LucasCorrea02/-Projeto---Acionamento-do-Motor-brushless/Diagrama Esquematico das Interfaces.bmp

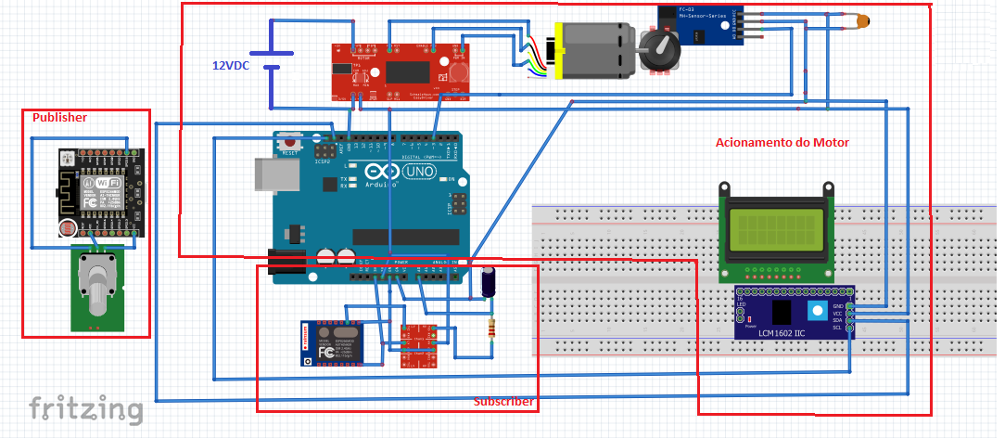
Diagrama Esquematico das Interfaces.bmp
